xelldran1/nrfmicro/README.md

# nrfmicro

This is an experimental (untested) devel branch

## Pictures

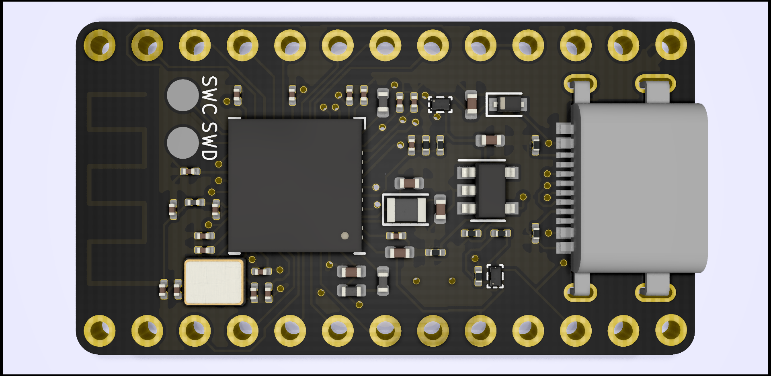
[picture p1: hardware/front.png]


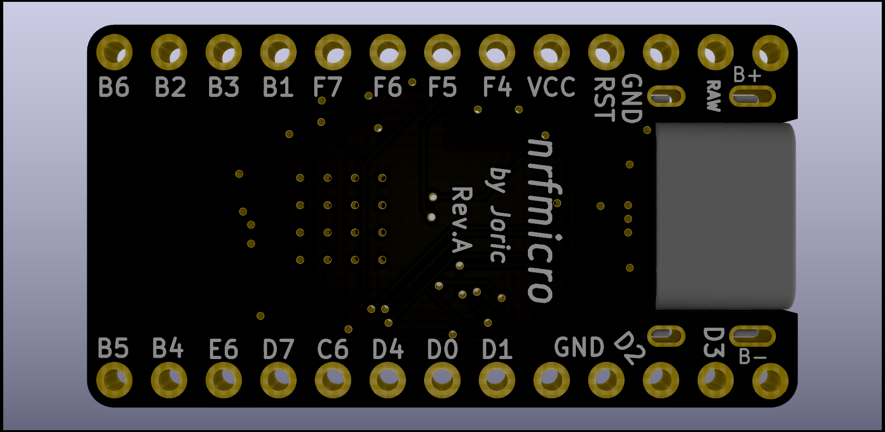
[picture p2: hardware/back.png]


## References

* https://github.com/joric/nrfmicro/wiki
