xelldran1/nrfmicro/hardware/nrfmicro.kicad_pcb

## KiCad design hardware/nrfmicro.kicad_pcb (2020-03-23)

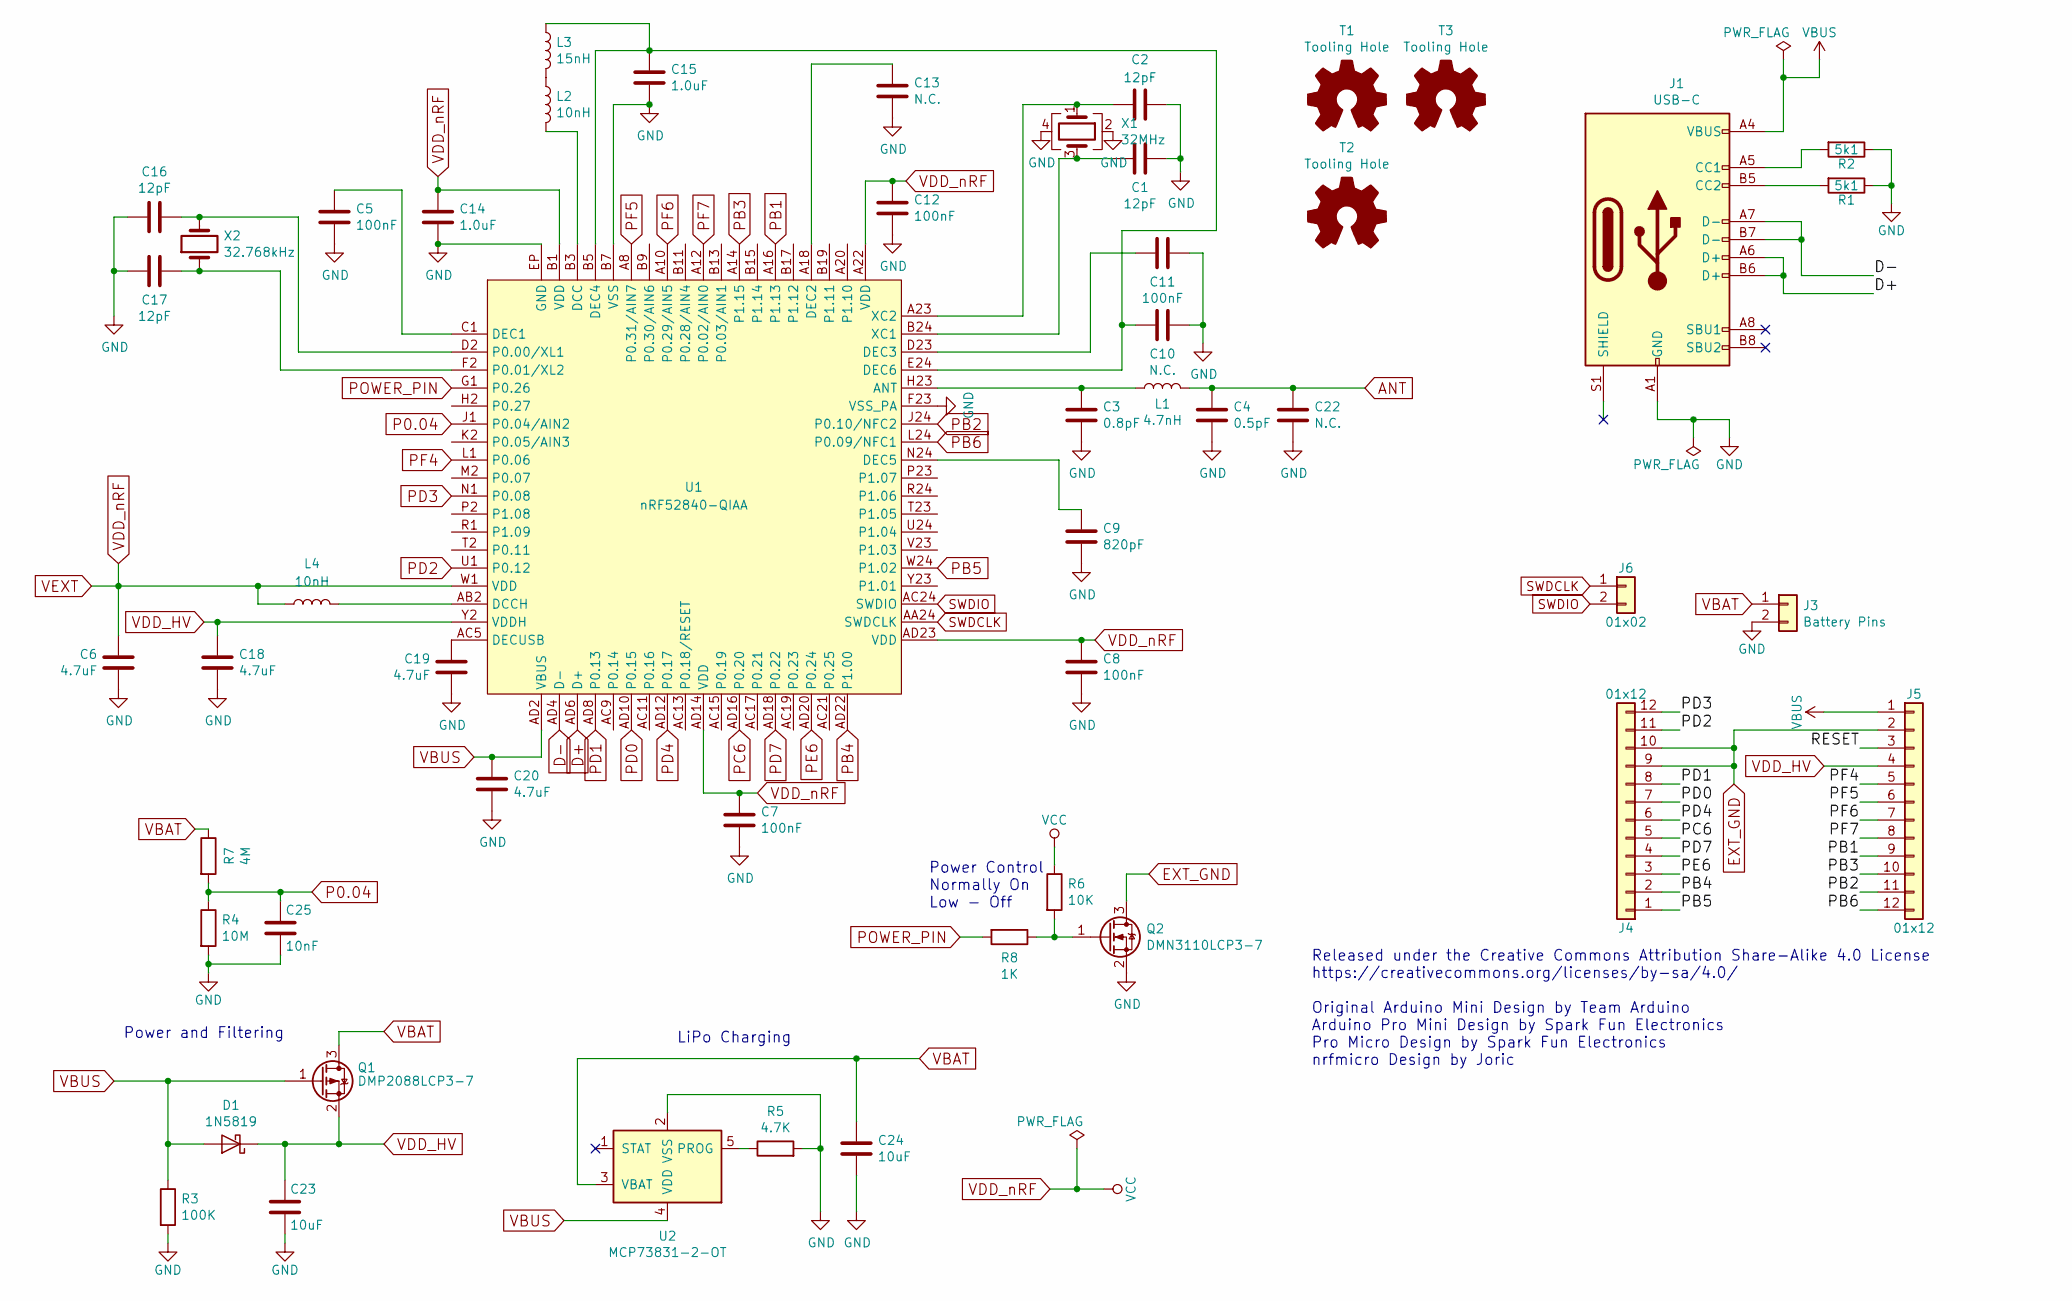
[picture p3: schematic nrfmicro.sch]

Parts:
C1, C2: 12pF; C_0201_0603Metric
C3: 0.8pF; C_0201_0603Metric
C4: 0.5pF; C_0201_0603Metric
C5, C7, C8, C11, C12: 100nF; C_0201_0603Metric
C6, C18, C19, C20: 4.7uF; C_0201_0603Metric
C9: 820pF; C_0201_0603Metric
C10, C13, C22: N.C.; C_0201_0603Metric
C14, C15: 1.0uF; C_0402_1005Metric
C16, C17: 12pF; C_0402_1005Metric
C23, C24: 10uF; C_0402_1005Metric
C25: 10nF; C_0201_0603Metric
D1: 1N5819; D_SOD-523
J1: USB-C; USB-C-C168688; LCSC C168688
J3: Battery Pins; connector_bat
J4, J5: 01x12; Pins12
J6: 01x02; connector_swd
L1: 4.7nH; L_0201_0603Metric
L2, L4: 10nH; L_0402_1005Metric
L3: 15nH; L_0402_1005Metric
Q1: DMP2088LCP3-7; X2-DSN1006-3; LCSC C461063
Q2: DMN3110LCP3-7; X2-DSN1006-3; LCSC C443826
R1, R2: 5k1; R_0201_0603Metric
R3: 100K; R_0201_0603Metric
R4: 10M; R_0201_0603Metric
R5: 4.7K; R_0201_0603Metric
R6: 10K; R_0201_0603Metric
R7: 4M; R_0201_0603Metric
R8: 1K; R_0201_0603Metric
T1, T2, T3: Tooling Hole; tooling_holes
U1: nRF52840-QIAA; Nordic_AQFN-73-1EP_7x7mm_P0.5mm; LCSC C190794
U2: MCP73831-2-OT; SOT-23-5
X1: 32MHz; Crystal_SMD_2016-4Pin_2.0x1.6mm; LCSC C341819
X2: 32.768kHz; Crystal_SMD_2012-2Pin_2.0x1.2mm; LCSC C99009

Connections:
/RESET: J5.3
ANT: C4.1, C22.1, L1.2
D+: J1.A6 (D+), J1.B6 (D+), U1.AD6 (D+)
D-: J1.A7 (D-), J1.B7 (D-), U1.AD4 (D-)
EXT_GND: J4.9, J4.10, J5.2, Q2.3 (D)
GND: C1.2, C2.2, C3.2, C4.2, C5.2, C6.2, C7.2, C8.2, C9.2, C10.2, C11.1, C12.2, C13.2, C14.2, C15.2, C16.2, C17.2, C18.2, C19.2, C20.2, C22.2, C23.2, C24.2, C25.2, J1.A1 (GND), J3.2, Q2.2 (S), R1.1, R2.1, R3.2, R4.2, R5.2, U1.B7 (VSS), U1.EP (GND), U1.F23 (VSS_PA), U2.2 (VSS), X1.2, X1.4
unnamed: C1.1, U1.B24 (XC1), X1.3
unnamed: C2.1, U1.A23 (XC2), X1.1
unnamed: C3.1, L1.1, U1.H23 (ANT)
unnamed: C5.1, U1.C1 (DEC1)
unnamed: C9.1, U1.N24 (DEC5)
unnamed: C10.1, C15.1, L3.1, U1.B5 (DEC4), U1.E24 (DEC6)
unnamed: C11.2, U1.D23 (DEC3)
unnamed: C13.1, U1.A18 (DEC2)
unnamed: C16.1, U1.D2 (P0.00/XL1), X2.2
unnamed: C17.1, U1.F2 (P0.01/XL2), X2.1
unnamed: C19.1, U1.AC5 (DECUSB)
unnamed: J1.A5 (CC1), R2.2
unnamed: J1.B5 (CC2), R1.2
unnamed: L2.1, L3.2
unnamed: L2.2, U1.B3 (DCC)
unnamed: L4.2, U1.AB2 (DCCH)
unnamed: Q2.1 (G), R6.2, R8.1
unnamed: R5.1, U2.5 (PROG)
P0.04: C25.1, R4.1, R7.2, U1.J1 (P0.04/AIN2)
PB1: J5.9, U1.A16 (P1.13)
PB2: J5.11, U1.J24 (P0.10/NFC2)
PB3: J5.10, U1.A14 (P1.15)
PB4: J4.2, U1.AD22 (P1.00)
PB5: J4.1, U1.W24 (P1.02)
PB6: J5.12, U1.L24 (P0.09/NFC1)
PC6: J4.5, U1.AD16 (P0.20)
PD0: J4.7, U1.AD10 (P0.15)
PD1: J4.8, U1.AD8 (P0.13)
PD2: J4.11, U1.U1 (P0.12)
PD3: J4.12, U1.N1 (P0.08)
PD4: J4.6, U1.AD12 (P0.17)
PD7: J4.4, U1.AD18 (P0.22)
PE6: J4.3, U1.AD20 (P0.24)
PF4: J5.5, U1.L1 (P0.06)
PF5: J5.6, U1.A8 (P0.31/AIN7)
PF6: J5.7, U1.A10 (P0.29/AIN5)
PF7: J5.8, U1.A12 (P0.02/AIN0)
POWER_PIN: R8.2, U1.G1 (P0.26)
SWDCLK: J6.1, U1.AA24 (SWDCLK)
SWDIO: J6.2, U1.AC24 (SWDIO)
VBAT: C24.1, J3.1, Q1.3 (D), R7.1, U2.3 (VBAT)
VBUS: C20.1, D1.2 (A), J1.A4 (VBUS), J5.1, Q1.1 (G), R3.1, U1.AD2 (VBUS), U2.4 (VDD)
VDD_HV: C18.1, C23.1, D1.1 (K), J5.4, Q1.2 (S), U1.Y2 (VDDH)
VDD_nRF: C6.1, C7.1, C8.1, C12.1, C14.1, L4.1, R6.1, U1.A22 (VDD), U1.AD14 (VDD), U1.AD23 (VDD), U1.B1 (VDD), U1.W1 (VDD)

Notes on the sheet:
Released under the Creative Commons Attribution Share-Alike 4.0 License https://creativecommons.org/licenses/by-sa/4.0/ Original Arduino Mini Design by Team Arduino Arduino Pro Mini Design by Spark Fun Electronics Pro Micro Design by Spark Fun Electronics nrfmicro Design by Joric
Power and Filtering
LiPo Charging
Power Control Normally On Low - Off

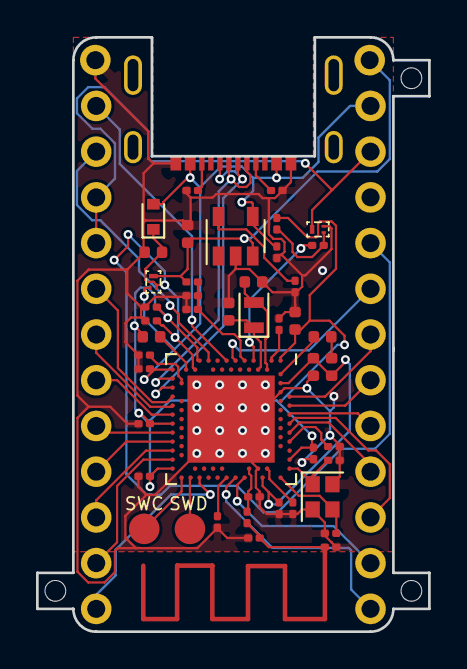
[picture p4: board nrfmicro.kicad_pcb from above]

Board: 2 copper layers, 21.8 x 33.0 mm, 51 parts (0 on the bottom side), 49 nets.
