xelldran1/nrfmicro/(commit log)

2019-12-01 updated files
    [nrfmicro.kicad_pcb, nrfmicro.sch]
2019-12-12 last commit
    [nrfmicro.kicad_pcb, nrfmicro.sch]
2020-02-28 added battery and power mosfet resistors
    [nrfmicro.kicad_pcb, nrfmicro.sch]
